Foxlil/Rhombic-stirling-model/CAD/Gear.step

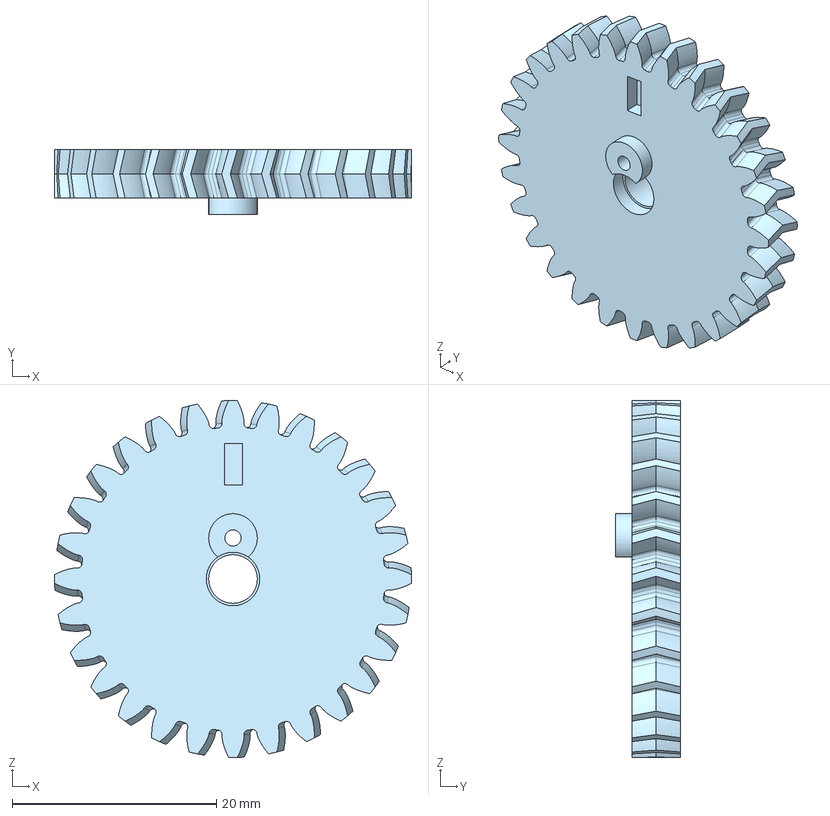
[picture p1: CAD file, 2026-11-06]
CAD/Gear.step
35.0 x 6.35 x 35.0 mm
