Foxlil/Rhombic-stirling-model/CAD/Linkage.step

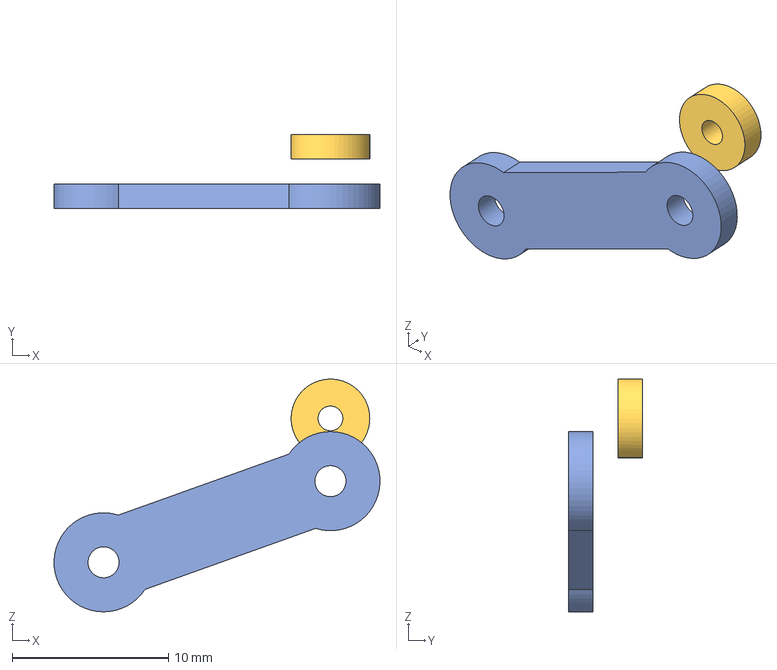
[picture p2: CAD file, 2026-11-06]
CAD/Linkage.step
20.9 x 4.76 x 14.9 mm
