Foxlil/Rhombic-stirling-model/CAD/Stopper.step

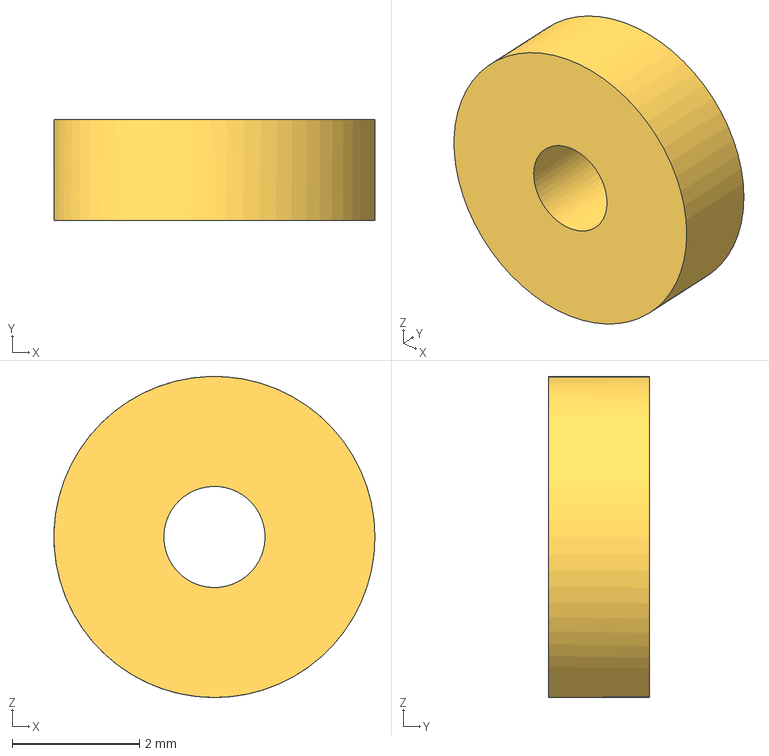
[picture p3: CAD file, 2026-11-06]
CAD/Stopper.step
5.04 x 1.59 x 5.04 mm
