Foxlil/Rhombic-stirling-model/CAD/Power piston.step

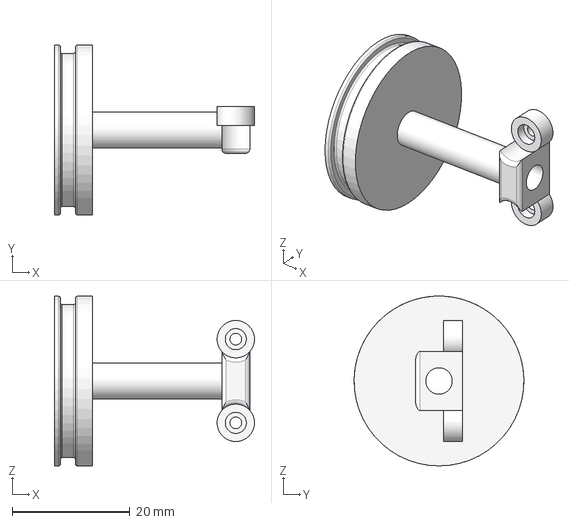
[picture p4: CAD file, 2026-11-06]
CAD/Power piston.step
34.0 x 28.8 x 28.8 mm
