Foxlil/Rhombic-stirling-model/CAD/Gear holder top part.step

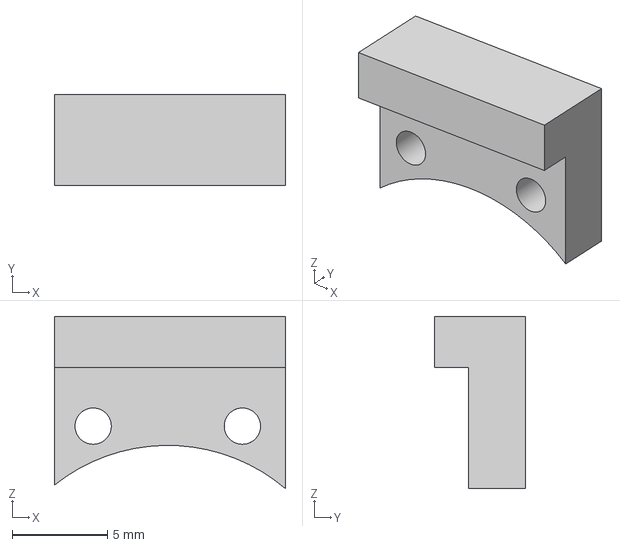
[picture p5: CAD file, 2026-11-06]
CAD/Gear holder top part.step
12.1 x 4.76 x 9.04 mm
