Foxlil/Rhombic-stirling-model/CAD/Gear holder middle.step

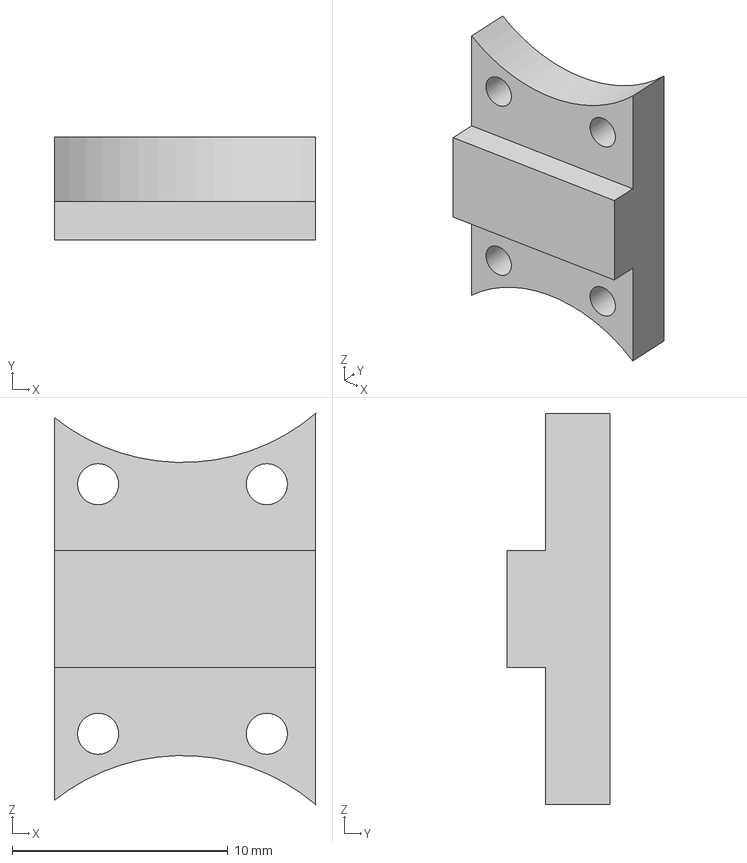
[picture p6: CAD file, 2026-11-05]
CAD/Gear holder middle.step
12.1 x 4.76 x 18.1 mm
