Foxlil/Rhombic-stirling-model/CAD/Gear holder bottom.step

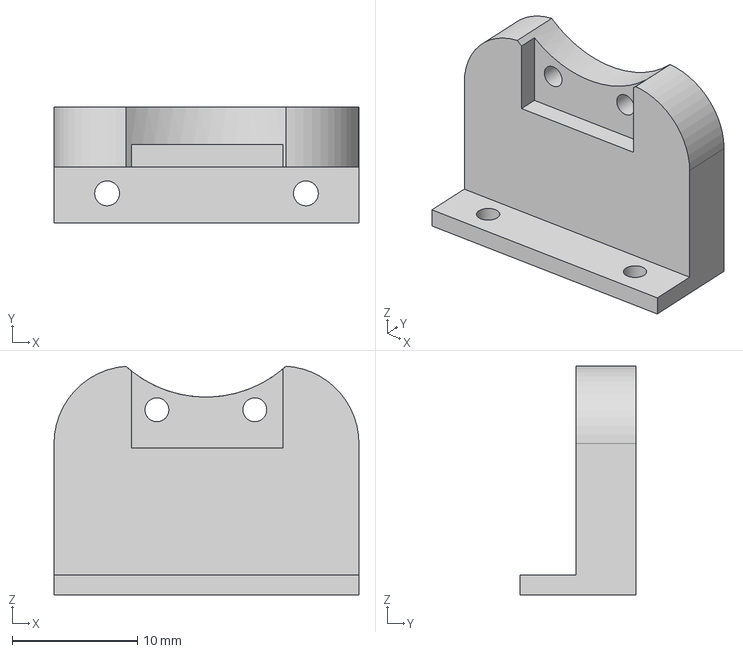
[picture p7: CAD file, 2026-11-05]
CAD/Gear holder bottom.step
24.4 x 9.24 x 18.3 mm
