Foxlil/Rhombic-stirling-model/CAD/Flywheel.step

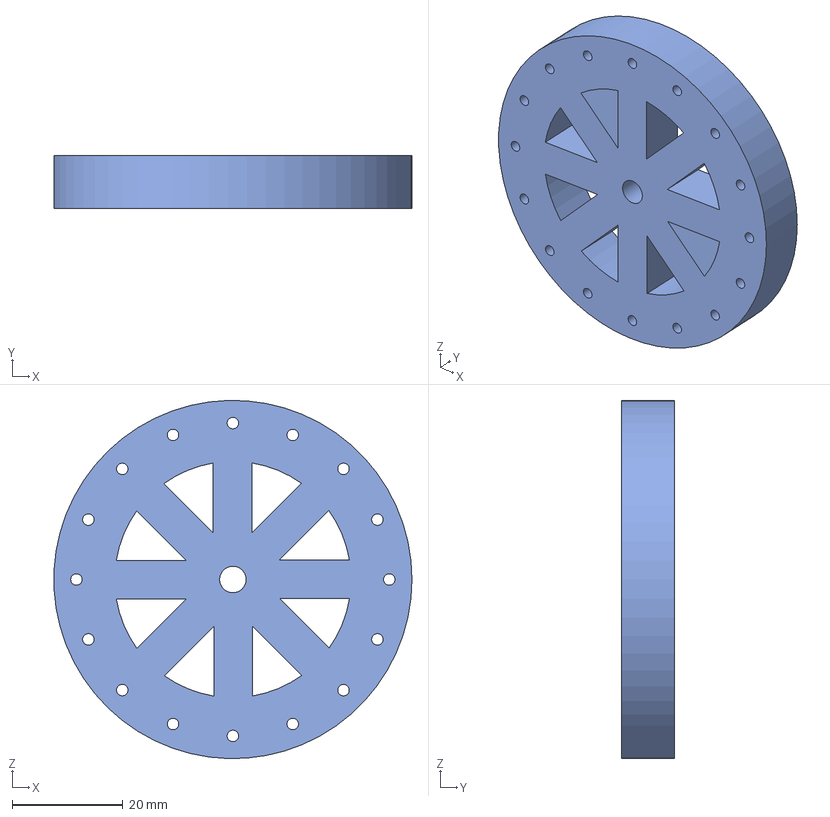
[picture p8: CAD file, 2026-11-05]
CAD/Flywheel.step
64.5 x 9.52 x 64.5 mm
