Foxlil/Rhombic-stirling-model/CAD/Displacer head.step

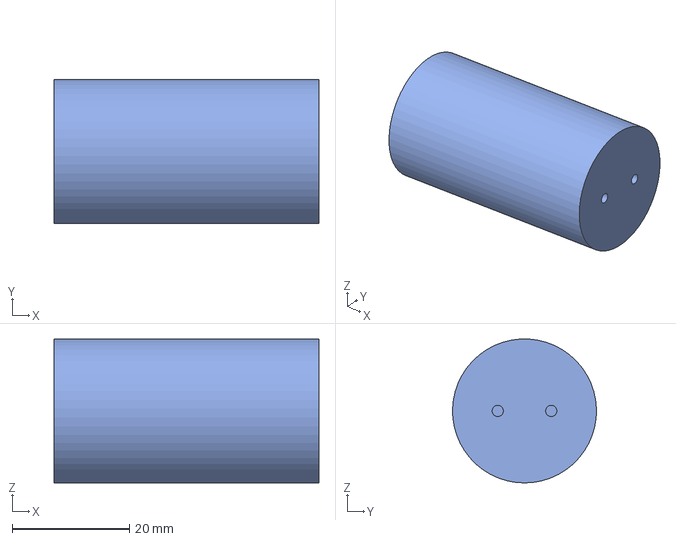
[picture p9: CAD file, 2026-11-05]
CAD/Displacer head.step
45.2 x 24.5 x 24.5 mm
