Foxlil/Rhombic-stirling-model/CAD/Displacer end.step

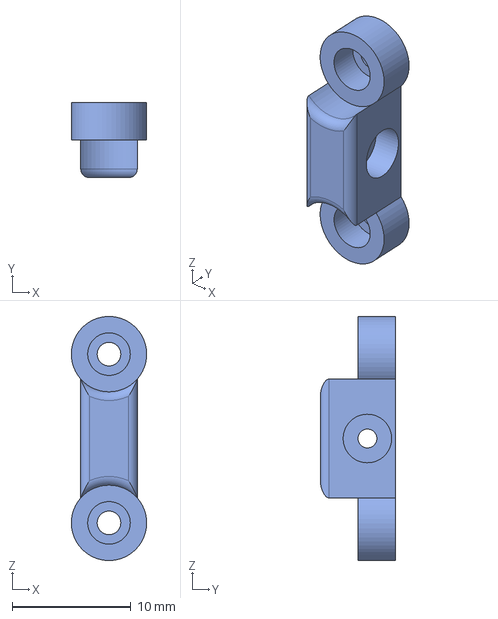
[picture p10: CAD file, 2026-11-05]
CAD/Displacer end.step
6.35 x 6.35 x 20.5 mm
