Foxlil/Rhombic-stirling-model/CAD/Displacer connecting rod.step

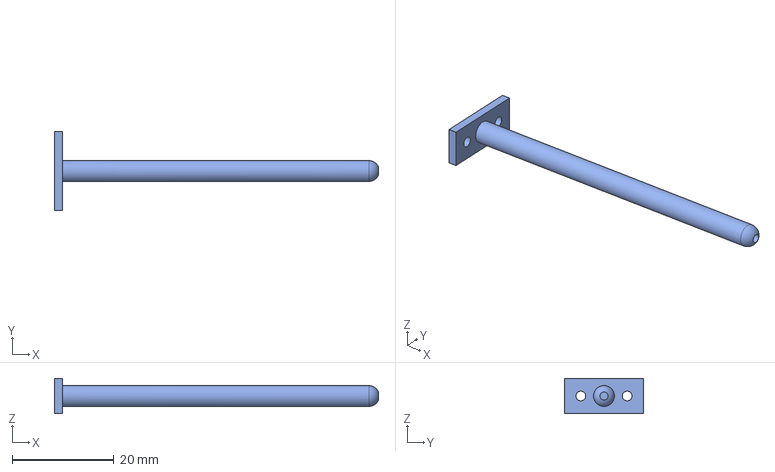
[picture p11: CAD file, 2026-11-05]
CAD/Displacer connecting rod.step
63.6 x 15.5 x 6.87 mm
