Foxlil/Rhombic-stirling-model/CAD/Cylinder.step

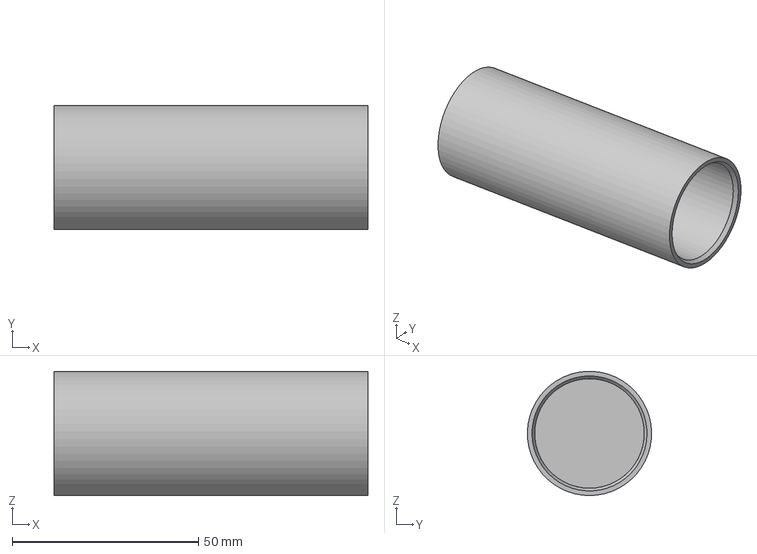
[picture p12: CAD file, 2026-11-05]
CAD/Cylinder.step
84.2 x 33.3 x 33.3 mm
