Foxlil/Rhombic-stirling-model/CAD/Short axle.step

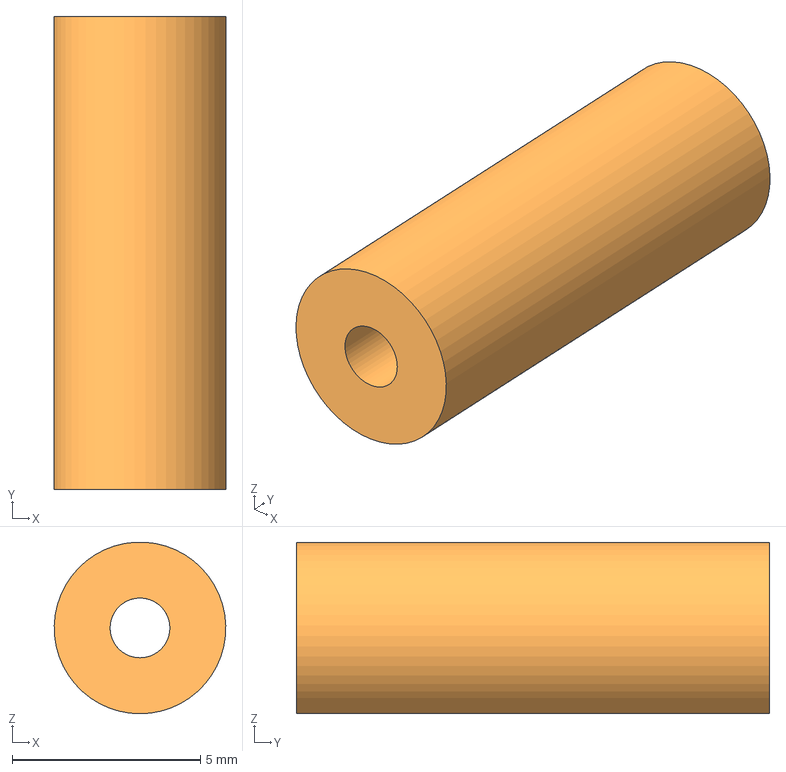
[picture p13: CAD file, 2026-11-05]
CAD/Short axle.step
4.56 x 12.6 x 4.56 mm
