Foxlil/Rhombic-stirling-model/CAD/Bearing limiter (smaller axle).step

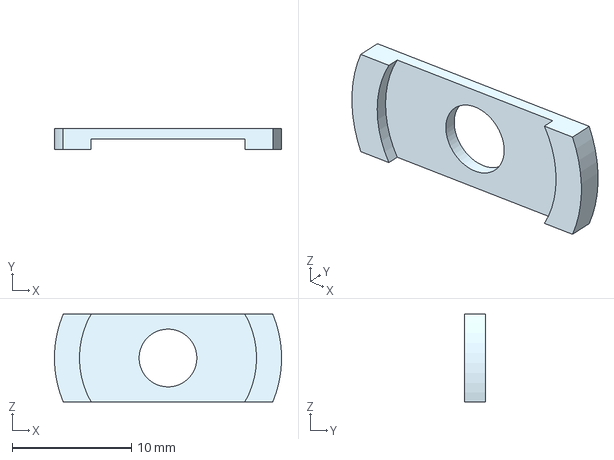
[picture p14: CAD file, 2026-11-05]
CAD/Bearing limiter (smaller axle).step
19.0 x 1.78 x 7.34 mm
