Foxlil/Rhombic-stirling-model/CAD/Bearing limiter (longer axle).step

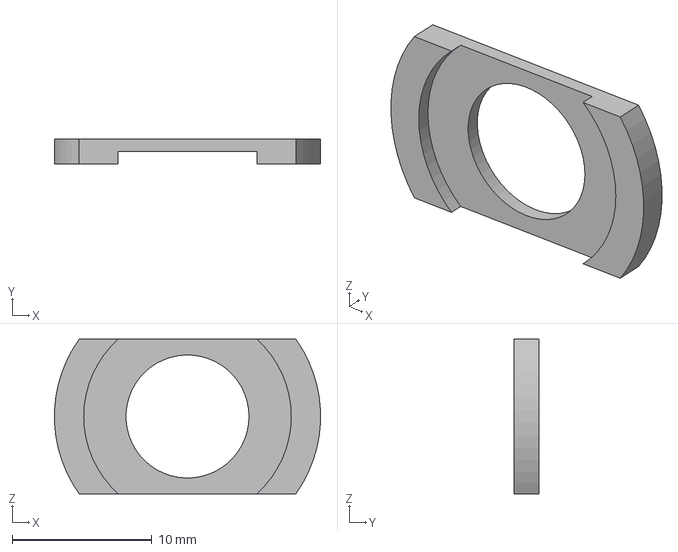
[picture p15: CAD file, 2026-11-05]
CAD/Bearing limiter (longer axle).step
19.0 x 1.78 x 11.1 mm
