Foxlil/Rhombic-stirling-model/CAD/Bearing for short axle.step

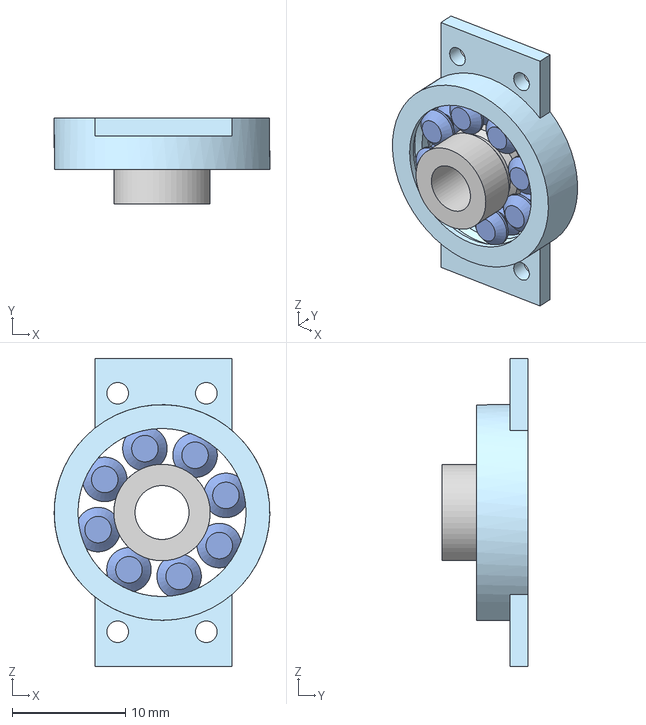
[picture p16: CAD file, 2026-11-05]
CAD/Bearing for short axle.step
19.0 x 7.62 x 27.2 mm
