Foxlil/Rhombic-stirling-model/CAD/Bearing for long axle.step

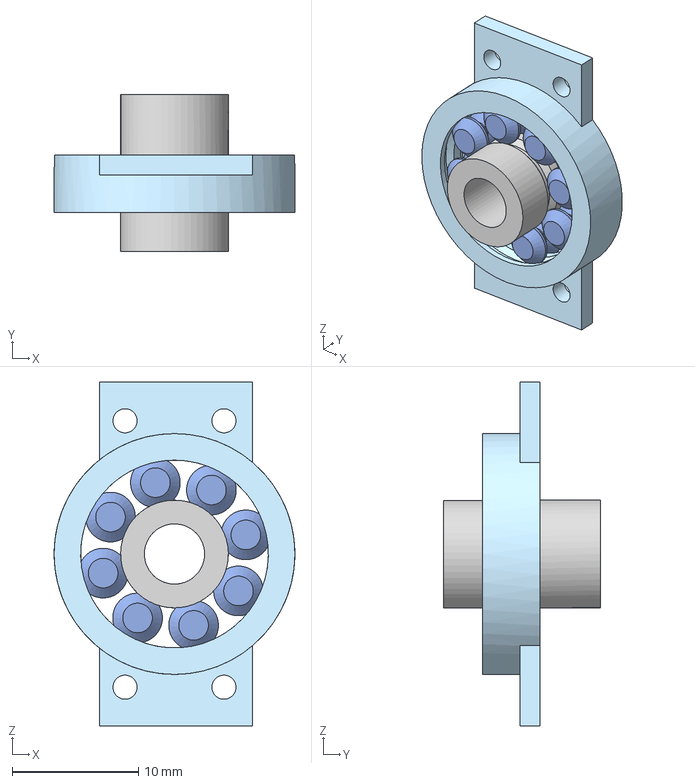
[picture p17: CAD file, 2026-11-04]
CAD/Bearing for long axle.step
19.1 x 12.4 x 27.2 mm
