Foxlil/Rhombic-stirling-model/CAD/Bearing cover.step

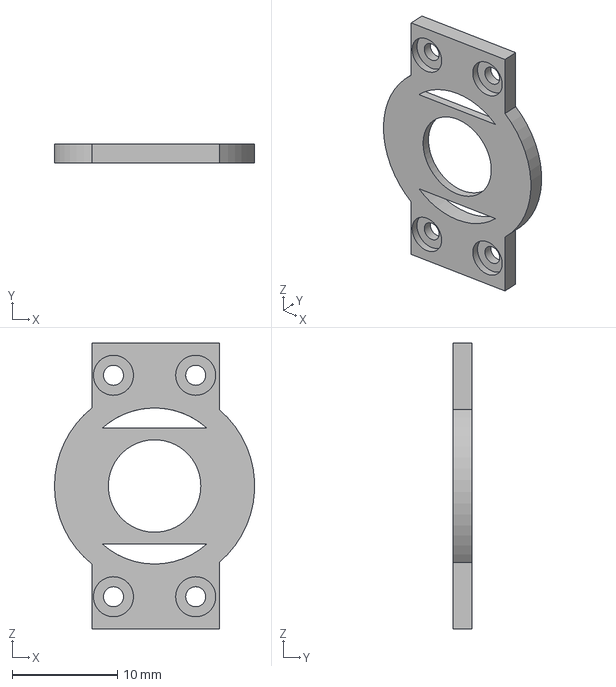
[picture p18: CAD file, 2026-11-04]
CAD/Bearing cover.step
19.0 x 1.78 x 27.2 mm
