Foxlil/Rhombic-stirling-model/CAD/Base.step

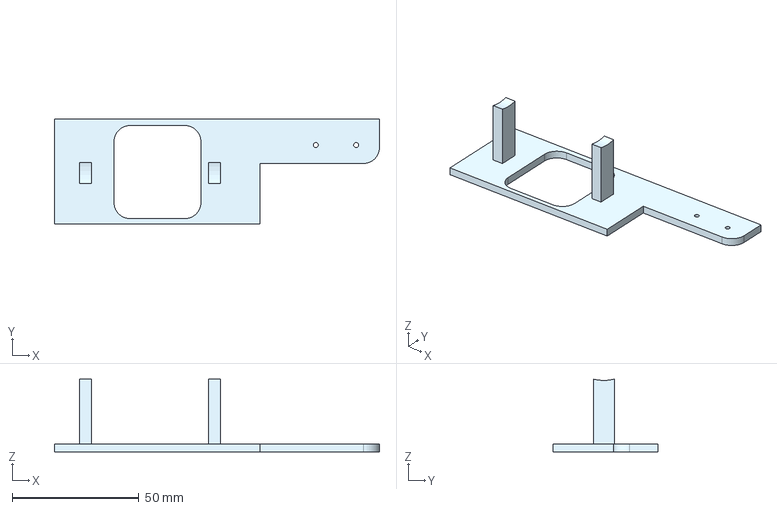
[picture p19: CAD file, 2026-11-04]
CAD/Base.step
128.0 x 41.3 x 28.7 mm
