Foxlil/Rhombic-stirling-model/CAD/Axle for gear+flywheel (long).step

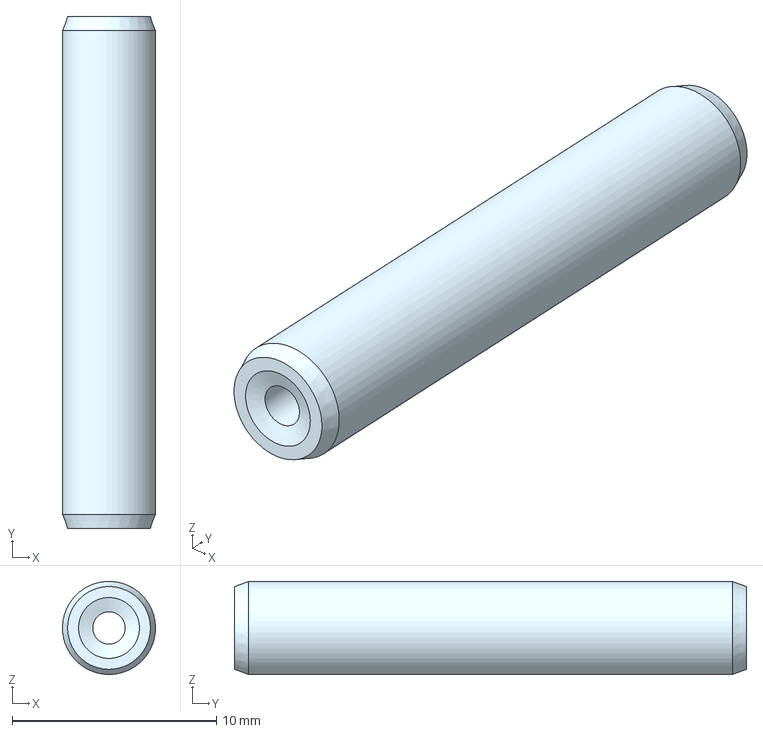
[picture p20: CAD file, 2026-11-04]
CAD/Axle for gear+flywheel (long).step
4.56 x 25.1 x 4.56 mm
