Foxlil/Rhombic-stirling-model/(commit log)

2026-10-28 Update README with print settings and images
2026-10-28 Added linkage stl
    [linkage.stl]
2026-10-28 Added gear stl file
    [Gear.stl]
2026-10-28 Added stopper stl file
    Prevents play in gears
    [Stopper.stl]
2026-10-28 Added flywheel stl file
    [Flywheel.stl]
2026-10-28 Added axle stl file
    [Axle for gear+flywheel.stl]
2026-10-28 Added shorter axle stl file
    [Shorter axle.stl]
2026-10-28 Added displacer connecting rod stl file
    [Displacer connecting rod.stl]
2026-10-28 Added displacer head stl file
    [Displacer head.stl]
2026-10-28 Added power piston stl file
    [Power piston.stl]
2026-10-28 Added cylinder stl file
    [Cylinder.stl]
2026-10-28 Base stl file
    [Base.stl]
2026-10-28 Added displacer end
    [Displacer end.stl]
2026-10-28 Added bearing cover stl file
    [Bearing cover.stl]
2026-10-28 Added gear holder top part stl
    [Gear holder top part.stl]
2026-10-28 Added gear holder middle part stl
    [Gear holder middle.stl]
2026-10-28 Gear holder bottom part stl added
    [Gear holder bottom.stl]
2026-10-28 Added bearing for short axle stil file
    [Bearing for short axle.stl]
2026-10-28 Added bearing for long axle stl file
    [Bearing for long axle.stl]
2026-10-28 Added bearing limiter 1 stl file
    [Bearing limiter (longer axle).stl]
2026-10-28 Added bearing limiter for smaller axle stl file
    [Bearing limiter (smaller axle).stl]
2026-10-28 Add bill of materials with product details
    [BOM.csv]
2026-10-28 Enhance README with materials and assembly images
2026-10-28 Added folder for stl files
2026-10-28 Added specific instructions to assembly
2026-11-01 Added assembly CAD of Stirling engine
    [Assembly.step]
2026-11-04 Deleted Axle for gear+flywheel.stl
    [Axle for gear+flywheel.stl]
2026-11-04 Added axle for gear+flywheel.step
    [Axle for gear+flywheel.step]
2026-11-04 Deleted Base.stl
    [Base.stl]
2026-11-04 Added base STEP file
    [Base.step]
2026-11-04 Deleted Bearing cover.stl
    [Bearing cover.stl]
2026-11-04 Added bearing cover as step file
    [Bearing cover.step]
2026-11-04 Deleted Bearing for long axle.stl
    [Bearing for long axle.stl]
2026-11-04 Added Bearing for long axle.step
    [Bearing for long axle.step]
2026-11-04 Added CAD folder
    [Assembly.step]
2026-11-05 Deleted Bearing for short axle.stl
    [Bearing for short axle.stl]
2026-11-05 Added bearing for short angle STEP file
    [Bearing for short axle.step]
2026-11-05 Deleted Bearing limiter (longer axle).stl
    [Bearing limiter (longer axle).stl]
2026-11-05 Added bearing limiter (longer axle).step
    [Bearing limiter (longer axle).step]
2026-11-05 Deleted Bearing limiter (smaller axle).stl
    [Bearing limiter (smaller axle).stl]
2026-11-05 Added Bearing limiter (smaller axle).step
    [Bearing limiter (smaller axle).step]
2026-11-05 Added "long" to file name
    [Axle for gear+flywheel (long).step]
2026-11-05 Added short axle file
    [Short axle.step]
2026-11-05 Deleted Cylinder.stl
    [Cylinder.stl]
2026-11-05 Added cylinder as STEP file
    [Cylinder.step]
2026-11-05 Deleted Displacer connecting rod.stl
    [Displacer connecting rod.stl]
2026-11-05 Added displacer connecting rod step
    [Displacer connecting rod.step]
2026-11-05 Deleted Displacer end.stl
    [Displacer end.stl]
2026-11-05 Added displacer end as step file
    [Displacer end.step]
2026-11-05 Deleted Displacer head.stl
    [Displacer head.stl]
2026-11-05 Added displacer head step version
    [Displacer head.step]
2026-11-05 Deleted Flywheel.stl
    [Flywheel.stl]
2026-11-05 Added flywheel step file
    [Flywheel.step]
2026-11-05 Deleted Gear holder bottom.stl
    [Gear holder bottom.stl]
2026-11-05 Added gear holder bottom as step
    [Gear holder bottom.step]
2026-11-05 Deleted Shorter axle.stl
    [Shorter axle.stl]
2026-11-05 Deleted Gear holder middle.stl
    [Gear holder middle.stl]
2026-11-05 Added gear holder middle step file
    [Gear holder middle.step]
2026-11-05 Moved file to CAD folder
    [Axle for gear+flywheel (long).step]
2026-11-06 Deleted Gear holder top part.stl
    [Gear holder top part.stl]
2026-11-06 Added gear holder top part as STEP file
    [Gear holder top part.step]
2026-11-06 Deleted Gear.stl
    [Gear.stl]
2026-11-06 Added gear as step file
    [Gear.step]
2026-11-06 Deleted Power piston.stl
    [Power piston.stl]
2026-11-06 Added power piston step file
    [Power piston.step]
2026-11-06 Deleted Stopper.stl
    [Stopper.stl]
2026-11-06 Added stopper as step file
    [Stopper.step]
2026-11-06 Deleted linkage.stl
    [linkage.stl]
2026-11-06 Added linkage as step file
    [Linkage.step]
2026-11-06 Added to CAD folder
    [Bearing cover.step]
2026-11-06 Deleted CAD/Gear.step
    [Gear.step]
2026-11-06 Updated Gear.step and added to folder
    [Gear.step]
2026-11-06 Moved to CAD folder
    [Linkage.step]
2026-11-07 Added note on shipping
    [BOM.csv]
2026-11-11 Added BOM file
    Just realized that csv is for sheets (-u - | | ), so downloaded from google sheets
    [BOM - Sheet1.csv]
2026-11-11 Deleted BOM.csv
    [BOM.csv]
2026-11-11 Deleted BOM - Sheet1.csv
    [BOM - Sheet1.csv]
2026-11-11 Added fixed BOM
    [BOM - Sheet1.csv]
